tamberg/fhnw-iot-project-example/(threads)

Thread 2 (2019-04-20):

GPIO pin collision

tamberg, 2019-04-20:
Using the Grove adapter, the DHT11 Grove sensor requires port D2, which on nRF52840 is pin 5. Unfortunately pin 5 is also required by the RMF95 LoRaWAN shield, see [mapping](https://github.com/tamberg/fhnw-iot/wiki/FeatherWing-RFM95W#mapping). Same for D4 = pin 9.

tamberg, 2019-04-20:
Solution: use adapter port A4, nRF52840 pin A2 (which can be used as digital port).

Closed 2019-04-22.

Thread 5 (2019-04-27):

Data drops to 0

tamberg, 2019-04-27:
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

tamberg, 2019-04-27:
Might be caused by low battery. Logging battery volatage (if possible) might help with debugging.

tamberg, 2019-04-29:
After plugging the sensor device to USB power, values look fine again. So it really was the low battery.

Closed 2019-04-29.
