tamberg/fhnw-iot-project-example/(commit log)

2019-04-18 Added DHT11 test example code, cloned from Examples > DHT sensor library > DHTtester.
2019-04-18 Added Links to board, adapter.
2019-04-18 Added LoRaWAN test example code, cloned from https://github.com/tamberg/fhnw-iot/blob/master/08/Arduino/nRF52840_LoRaWANNodeAbp/nRF52840_LoRaWANNodeAbp.ino
2019-04-18 Fixed index to send exact bytes.
    [nRF52840_LoRaWAN_Test.ino]
2019-04-20 Added nRF52840 device source code.
